gfcwfzkm/t9k-baseboard/examples/README.md

# Example Projects

This directory contains example projects that demonstrate how to use the Tang Nano 9k board with this base board. Here a list of the example projects:

- [Simple Counter](01_starting_project): A simple counter that uses the six LEDs on the Tang Nano 9k board, serves as "Getting Started" project.

- [RGB LED and Rotary Encoder](02_RGBLED): A project that uses the RGB LED and the rotary encoder on the Tang Nano 9k board.

- [HDMI Demo](03_HDMI_demo): A demo that shows how to use the HDMI output on the Tang Nano 9k board. It generates a simple test color pattern and displays the Swiss flag on a 1920x1080@30p HDMI display.

- [Simple CPU](TC-Overture-CPU): A simple CPU that can execute a few instructions. It is a good starting point for learning how to build a CPU on the Tang Nano 9k board.
