gfcwfzkm/t9k-baseboard/examples/01_starting_project/README.md

# Simple Counter / Getting Started Project

This is a simple counter that uses the six LEDs on the Tang Nano 9k board. It serves as a "Getting Started" project. The LEDs count up every 6'750'000 clock cycles, or every quarter second. Uses the S1 button to reset the counter.
