gfcwfzkm/t9k-baseboard/docs/Pinmap.pdf

30.06.2024 | | | | | Pascal G. (https://github.com/gfcwfzkm/)
Feature | I/O NAME | PIN | PIN | I/O NAME | Feature
3.3V | 3.3V
1.1 | IOB33A | 39 | 28 | IOB11B | 1.1
1.2 | IOB29B | 36 | 27 | IOB11A | 1.2
1.3 | IOB31A | 37 | 26 | IOB8B | 1.3
1.4 | IOB31B | 38 | 25 | IOB8A | 1.4
1.5 | IOR24A | 49 | 34 | IOB23B | 1.5
1.6 | IOR24B | 48 | 33 | IOB23A | 1.6
1.7 | IOT37B | 76 | 30 | IOB13B | 1.7
1.8 | IOT37A | 77 | 29 | IOB13A | 1.8
3.3V | 3.3V
1.1 | IOB41B | 42 | 32 | IOB15B | 1.1
1.2 | IOB41A | 41 | 31 | IOB15A | 1.2
1.3 | IOB29A | 35 | 57 | IOR13A | 1.3
1.4 | IOB33B | 40 | 56 | IOR14A | 1.4
1.5 | IOR14B | 55
1.6 | IOR15A | 54
1.7 | IOR15B | 53 | 63 | IOR5A | RGBLED
1.8 | IOR17B | 51
1.8V
1.8V | 83 | IOT10B | Center
A | IOT10A | 84 | 82 | IOT11A | Left
B | IOT8B | 85 | 81 | IOT11B | Up
Center | IOT8A | 86 | 80 | IOT12A | Right
| | | 79 | IOT12B | Down
1.8V
LED1 | IOL15A | 10 | 3.3V
LED2 | IOL16B | 11 | 49 | IOR24A | R/S
LED3 | IOL21B | 13 | 77 | IOT37A | MOSI
LED4 | IOL22B | 14 | 76 | IOT37B | SCLK
LED5 | IOL25B | 15 | 48 | IOR24B | !CS
LED6 | IOL26B | 16 | 47 | IOB43B | !Reset
1.8V | 3.3V
S1 | IOL5A | 4 | 38 | IOB31B | !CS
S2 | IOT2A | 3 | 37 | IOB31A | MOSI
| | | 36 | IOB29B | SCLK
3.3V | 39 | IOB33A | MISO
MOSI | IOR11B | 61
MISO | IOR11A | 62 | 3.3V
SCLK | IOR12B | 59 | 52 | IOR17A | 27 MHz
!CS | IOR12A | 60
3.3V
| | | 17 | IOB2A | FPGA-TX
| | | 18 | IOB2B | FPGA-RX

INFO

Note: All Buttons, Joysticks, Encoders or non-RGB LEDs are "Active-Low"!

# Tang Nano 9k FPGA Base board Shared with PMOD ¹ Shared with PMOD ¹

PMOD 1 | PMOD 2
PMOD 3 | PMOD 4

ENCODER

Shared with
TF CARD

Shared with
SPI LCD

PC UART

SPI FLASH

SerialRGB

JOYSTICK

SPI LCD

LEDs

BUTTONS | TF CARD

XTAL Clock
