gfcwfzkm/t9k-baseboard/images/3drender_1.png

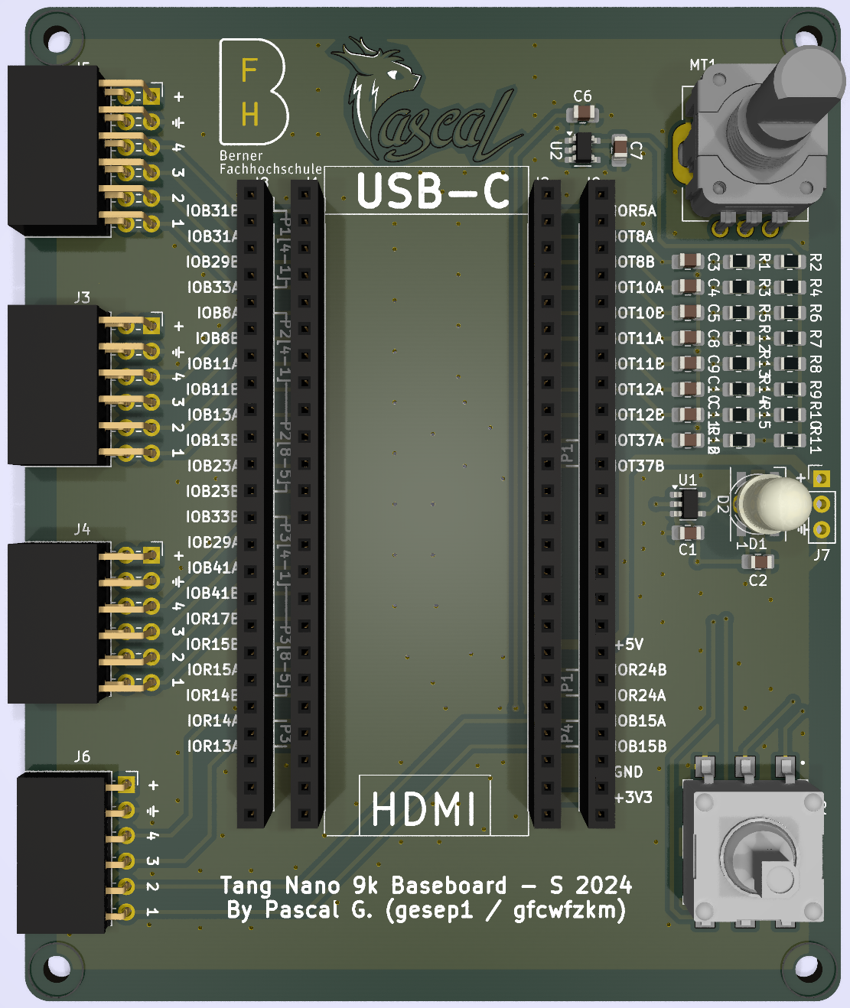
images/3drender_1.png
