gfcwfzkm/t9k-baseboard/images/3drender_2.png

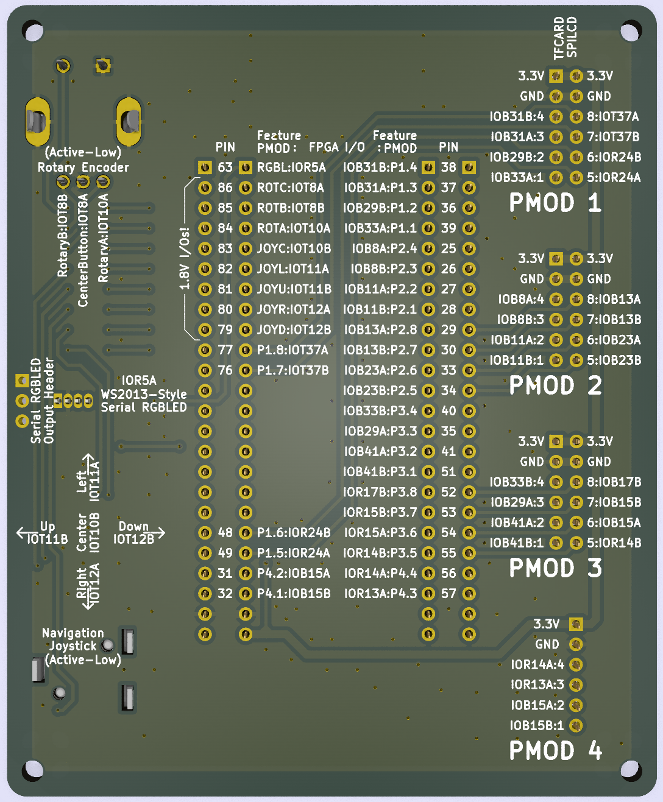
images/3drender_2.png
