gfcwfzkm/t9k-baseboard/docs/BOM.xlsx

Note: This BOM sheet summarizes the costs for a small production run of 10 pieces, which was the target of this project.
Reference | Value | Footprint | Qty | DNP | DigiKey_Part_Number | Price 10 PCS
C1,C2 | 100nF | Capacitor_SMD:C_0805_2012Metric_Pad1.18x1.45mm_HandSolder | 2 |  | 311-1140-1-ND | CHF 1.28 |  | +1 for everyone
C3,C4,C5,C8,C9,C10,C11,C12 | 10nF | Capacitor_SMD:C_0805_2012Metric_Pad1.18x1.45mm_HandSolder | 8 |  | 311-1136-1-ND | CHF 2.43 |  | +1 for everyone
C6,C7 | 2.2uF | Capacitor_SMD:C_0805_2012Metric_Pad1.18x1.45mm_HandSolder | 2 |  | 4713-GMC21X7R225K25NTCT-ND | CHF 1.16 |  | +1 for everyone
D1 | APA-106-F5 | LED_THT:LED_D5.0mm-4_RGB | 1 |  | 1568-1202-ND | CHF 12.76
J1,J2,J8,J9 | FPGA I/O | Connector_PinSocket_2.54mm:PinSocket_1x24_P2.54mm_Vertical | 4 |  | S7057-ND | CHF 45.68
J3,J4,J5 | PMOD-FULL | Connector_PinSocket_2.54mm:PinSocket_2x06_P2.54mm_Horizontal | 3 |  | 732-613012243121-ND | CHF 23.86
J6 | PMOD-HALF | Connector_PinSocket_2.54mm:PinSocket_1x06_P2.54mm_Horizontal | 1 |  | 732-613006143121-ND | CHF 4.90
MT1 | PEC11R-4115F-S0018 | PEC11R-4215F-S0024:XDCR_PEC11R-4215F-S0024 | 1 |  | PEC11R-4115F-S0018-ND | CHF 11.46
R1,R2,R3,R4,R5,R6,R7,R8,R9,R10,R11,R12,R13,R14,R15,R16 | 10k | Resistor_SMD:R_0805_2012Metric_Pad1.20x1.40mm_HandSolder | 16 |  | 311-10.0KCRCT-ND | CHF 2.06 |  | +2 for everyone
S1 | JS5208 | JS5208:SW_JS5208 | 1 |  | EG4561-ND | CHF 24.51
U1 | SN74LV1T34DBV | Package_TO_SOT_SMD:SOT-23-5 | 1 |  | 296-37176-1-ND | CHF 2.81 |  | 2 reserve, in case someone ruins / looses one
U2 | AP2205-18W5-7 | Package_TO_SOT_SMD:SOT-23-5 | 1 |  | 31-AP2205-18W5-7CT-ND | CHF 3.37
 |  |  |  | TOTAL COMPONENTS EXCL. FPGA: |  | CHF 136.28
PCB costs at JLCPCB (blue, HASL (lead), 2 Layers, 99 x 81 mm, 10 Stück |  |  |  |  |  | CHF 5.00 |  | ~20 CHF shipping
FPGA Sipeed Tang 9k |  | Base variant |  |  |  | CHF 14.68 | Students would order the FPGA separately as some students want other LCDs to go with it.
 |  | With 7" LCD |  |  |  | CHF 35.88
 |  | With 5" LCD |  |  |  | CHF 32.09
 |  | With 4.3" LCD |  |  |  | CHF 26.34
 |  | With 1.14" LCD |  |  |  | CHF 17.78
 | Project cost per student (Excl. Shipping, with FPGA base variant) |  |  |  |  | CHF 33.31
 |  |  | An FPGA Development System for around ~30 CHF!
