gfcwfzkm/t9k-baseboard/docs/SCHEMA.pdf

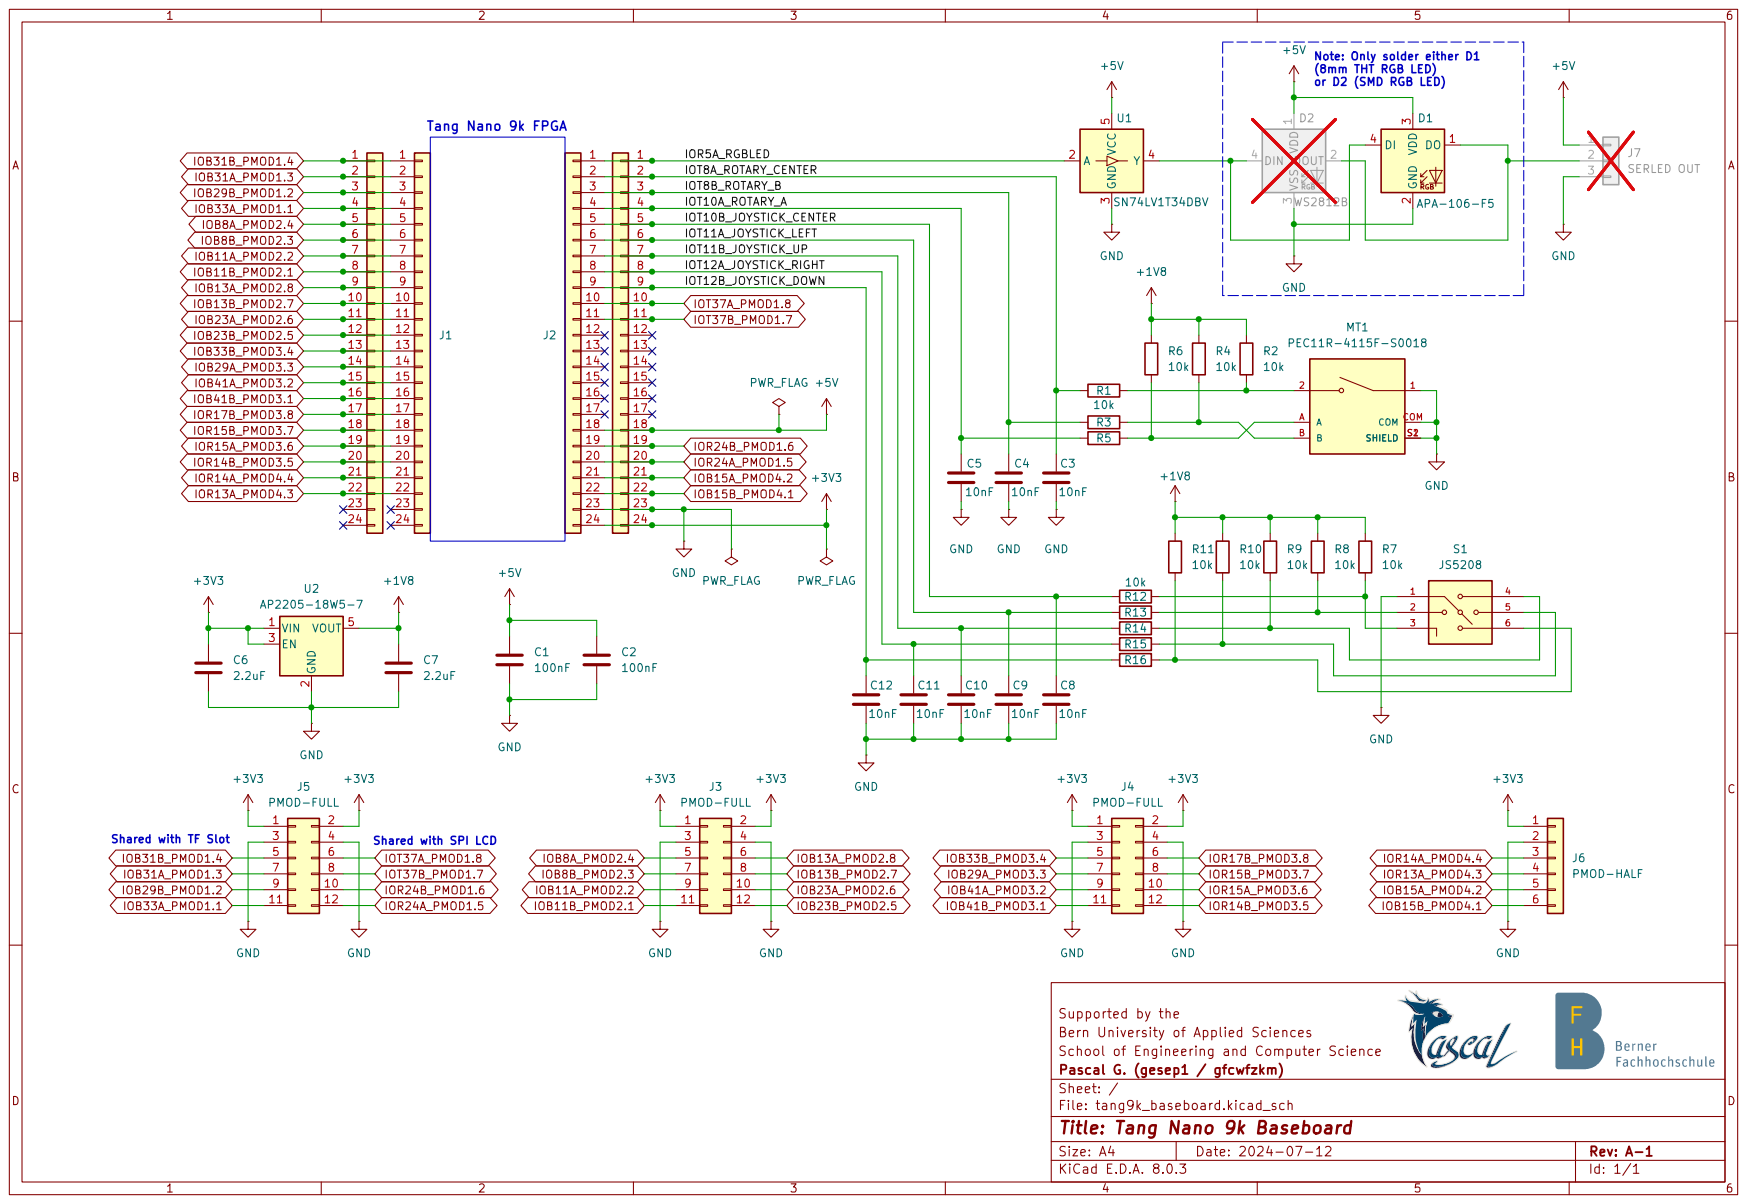
[picture p14: page 1]
