gfcwfzkm/t9k-baseboard/kicad/tang9k_baseboard.kicad_pcb

## KiCad design kicad/tang9k_baseboard.kicad_pcb (2024-07-13)

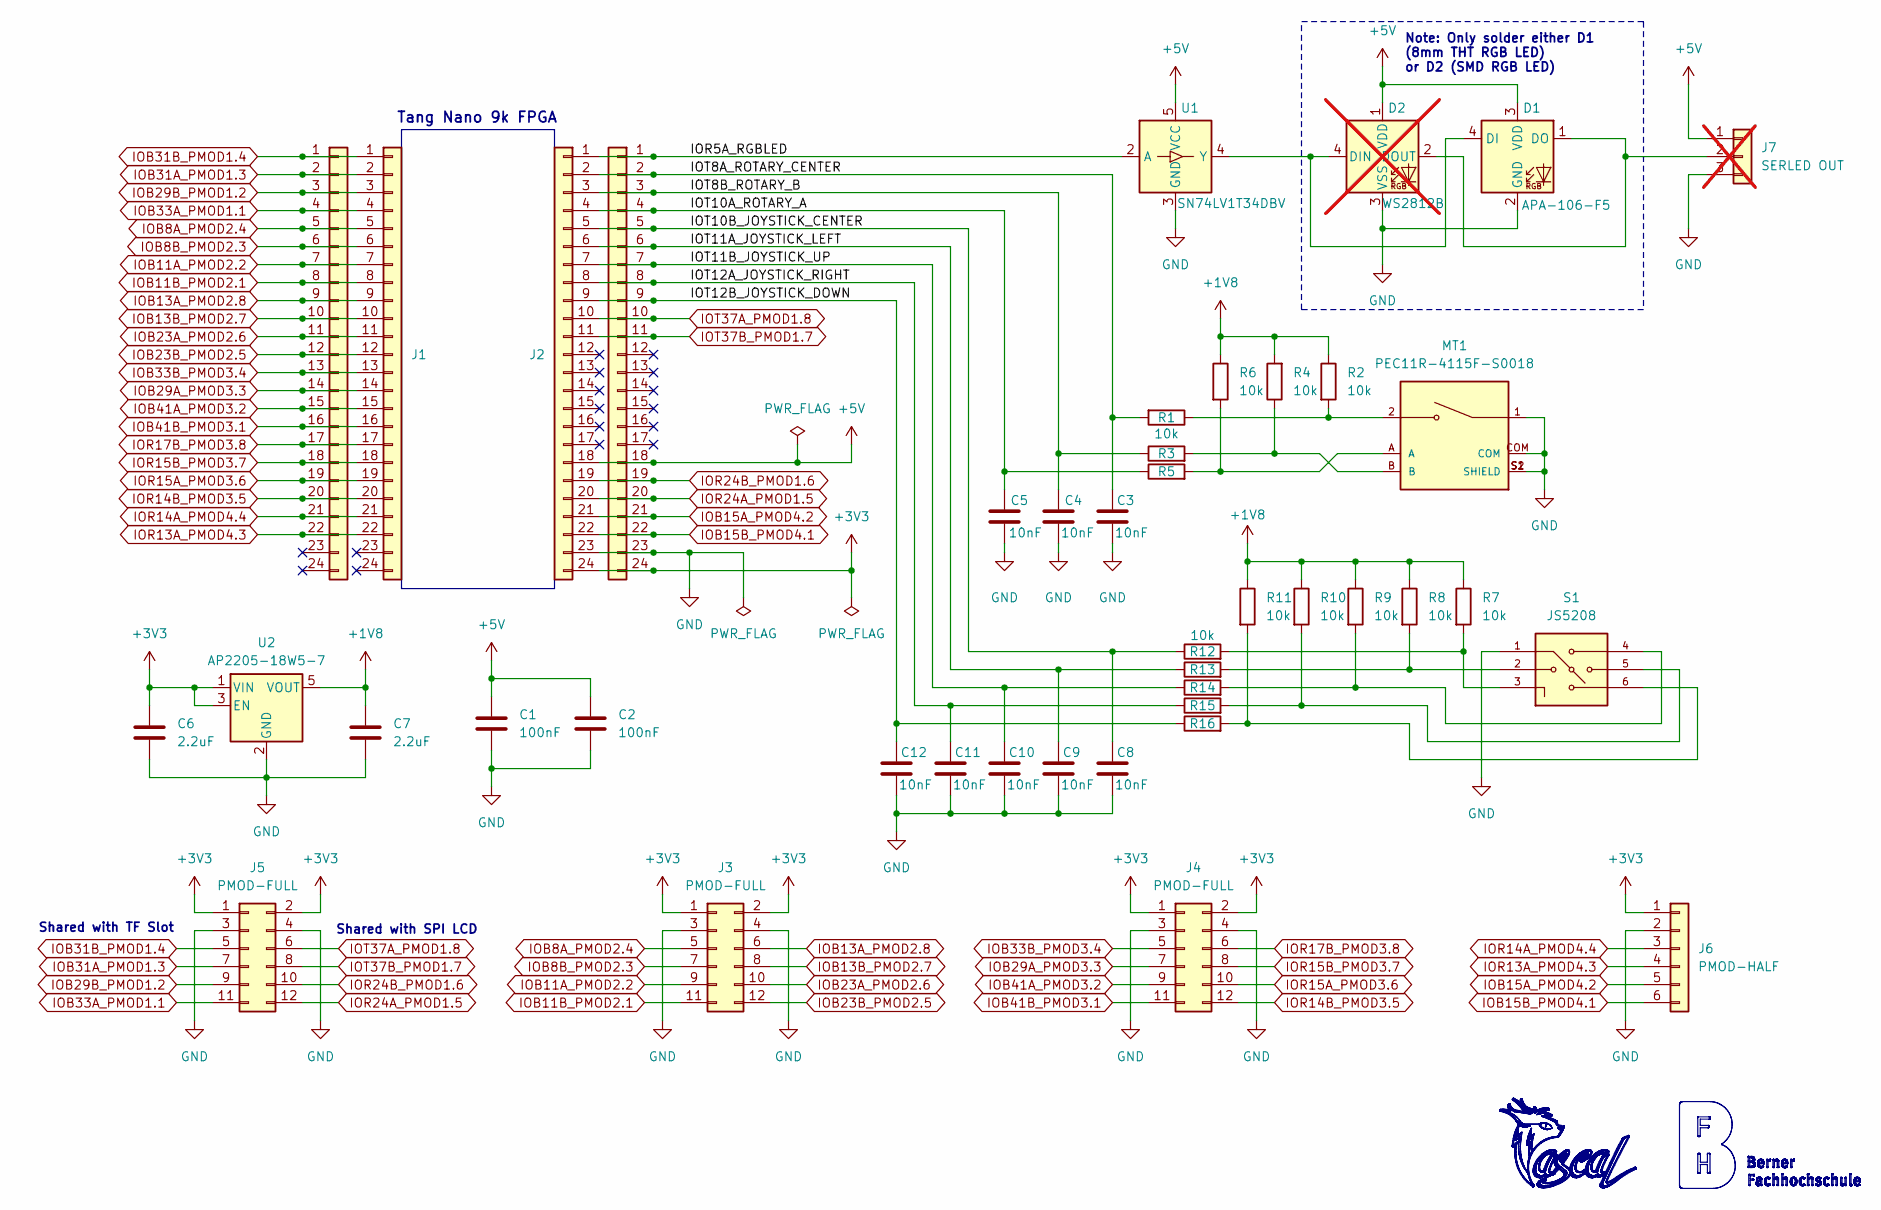
[picture p15: schematic tang9k_baseboard.kicad_sch, Tang Nano 9k Baseboard]

Parts:
C1, C2: 100nF; C_0805_2012Metric_Pad1.18x1.45mm_HandSolder; DigiKey_Part_Number 311-1140-1-ND
C3, C4, C5, C8, C9, C10, C11, C12: 10nF; C_0805_2012Metric_Pad1.18x1.45mm_HandSolder; DigiKey_Part_Number 311-1136-1-ND
C6, C7: 2.2uF; C_0805_2012Metric_Pad1.18x1.45mm_HandSolder; DigiKey_Part_Number 4713-GMC21X7R225K25NTCT-ND
D1: APA-106-F5; LED_D5.0mm-4_RGB; DigiKey_Part_Number 1568-1202-ND
D2: WS2812B; LED_WS2812B_PLCC4_5.0x5.0mm_P3.2mm; DigiKey_Part_Number 1568-COM-16347CT-ND; not fitted
J1, J2, J8, J9: FPGA I/O; PinSocket_1x24_P2.54mm_Vertical; DigiKey_Part_Number S7057-ND
J3, J4, J5: PMOD-FULL; PinSocket_2x06_P2.54mm_Horizontal; DigiKey_Part_Number 732-613012243121-ND
J6: PMOD-HALF; PinSocket_1x06_P2.54mm_Horizontal; DigiKey_Part_Number 732-613006143121-ND
J7: SERLED OUT; PinHeader_1x03_P2.54mm_Vertical; not fitted
MT1: PEC11R-4115F-S0018; XDCR_PEC11R-4215F-S0024; PARTREV Rev. 09/19; DigiKey_Part_Number PEC11R-4115F-S0018-ND
R1, R2, R3, R4, R5, R6, R7, R8, R9, R10, R11, R12, R13, R14, R15, R16: 10k; R_0805_2012Metric_Pad1.20x1.40mm_HandSolder; DigiKey_Part_Number 311-10.0KCRCT-ND
S1: JS5208; SW_JS5208; PARTREV D; DigiKey_Part_Number EG4561-ND
U1: SN74LV1T34DBV; SOT-23-5; DigiKey_Part_Number 296-37176-1-ND
U2: AP2205-18W5-7; SOT-23-5; DigiKey_Part_Number 31-AP2205-18W5-7CT-ND

Connections:
+1V8: C7.1, R2.1, R4.2, R6.1, R7.1, R8.1, R9.1, R10.1, R11.1, U2.5 (VOUT)
+3V3: C6.1, J2.24, J3.1, J3.2, J4.1, J4.2, J5.1, J5.2, J6.1, J9.24, U2.1 (VIN), U2.3 (EN)
+5V: C1.1, C2.1, D1.3 (VDD), D2.1 (VDD), J2.18, J7.1, J9.18, U1.5 (VCC)
/IOR5A_RGBLED: J2.1, J9.1, U1.2 (A)
/IOT8A_ROTARY_CENTER: C3.1, J2.2, J9.2, R1.2
/IOT8B_ROTARY_B: C4.1, J2.3, J9.3, R3.1
/IOT10A_ROTARY_A: C5.1, J2.4, J9.4, R5.1
/IOT10B_JOYSTICK_CENTER: C8.1, J2.5, J9.5, R12.1
/IOT11A_JOYSTICK_LEFT: C9.1, J2.6, J9.6, R13.1
/IOT11B_JOYSTICK_UP: C10.1, J2.7, J9.7, R14.1
/IOT12A_JOYSTICK_RIGHT: C11.1, J2.8, J9.8, R15.1
/IOT12B_JOYSTICK_DOWN: C12.1, J2.9, J9.9, R16.1
IOB8A_PMOD2.4: J1.5, J3.5, J8.5
IOB8B_PMOD2.3: J1.6, J3.7, J8.6
IOB11A_PMOD2.2: J1.7, J3.9, J8.7
IOB11B_PMOD2.1: J1.8, J3.11, J8.8
IOB13A_PMOD2.8: J1.9, J3.6, J8.9
IOB13B_PMOD2.7: J1.10, J3.8, J8.10
IOB15A_PMOD4.2: J2.21, J6.5, J9.21
IOB15B_PMOD4.1: J2.22, J6.6, J9.22
IOB23A_PMOD2.6: J1.11, J3.10, J8.11
IOB23B_PMOD2.5: J1.12, J3.12, J8.12
IOB29A_PMOD3.3: J1.14, J4.7, J8.14
IOB29B_PMOD1.2: J1.3, J5.9, J8.3
IOB31A_PMOD1.3: J1.2, J5.7, J8.2
IOB31B_PMOD1.4: J1.1, J5.5, J8.1
IOB33A_PMOD1.1: J1.4, J5.11, J8.4
IOB33B_PMOD3.4: J1.13, J4.5, J8.13
IOB41A_PMOD3.2: J1.15, J4.9, J8.15
IOB41B_PMOD3.1: J1.16, J4.11, J8.16
IOR13A_PMOD4.3: J1.22, J6.4, J8.22
IOR14A_PMOD4.4: J1.21, J6.3, J8.21
IOR14B_PMOD3.5: J1.20, J4.12, J8.20
IOR15A_PMOD3.6: J1.19, J4.10, J8.19
IOR15B_PMOD3.7: J1.18, J4.8, J8.18
IOR17B_PMOD3.8: J1.17, J4.6, J8.17
IOR24A_PMOD1.5: J2.20, J5.12, J9.20
IOR24B_PMOD1.6: J2.19, J5.10, J9.19
IOT37A_PMOD1.8: J2.10, J5.6, J9.10
IOT37B_PMOD1.7: J2.11, J5.8, J9.11
unnamed: D1.4 (DI), D2.4 (DIN), U1.4 (Y)
unnamed: D1.1 (DO), D2.2 (DOUT), J7.2
unnamed: MT1.2, R1.1, R2.2
unnamed: MT1.A, R5.2, R6.2
unnamed: MT1.B, R3.2, R4.1
unnamed: R10.2, R15.2, S1.5
unnamed: R11.2, R16.2, S1.6
unnamed: R8.2, R13.2, S1.2
unnamed: R9.2, R14.2, S1.4

Notes on the sheet:
Tang Nano 9k FPGA
Note: Only solder either D1 (8mm THT RGB LED) or D2 (SMD RGB LED)
Shared with SPI LCD
Shared with TF Slot

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
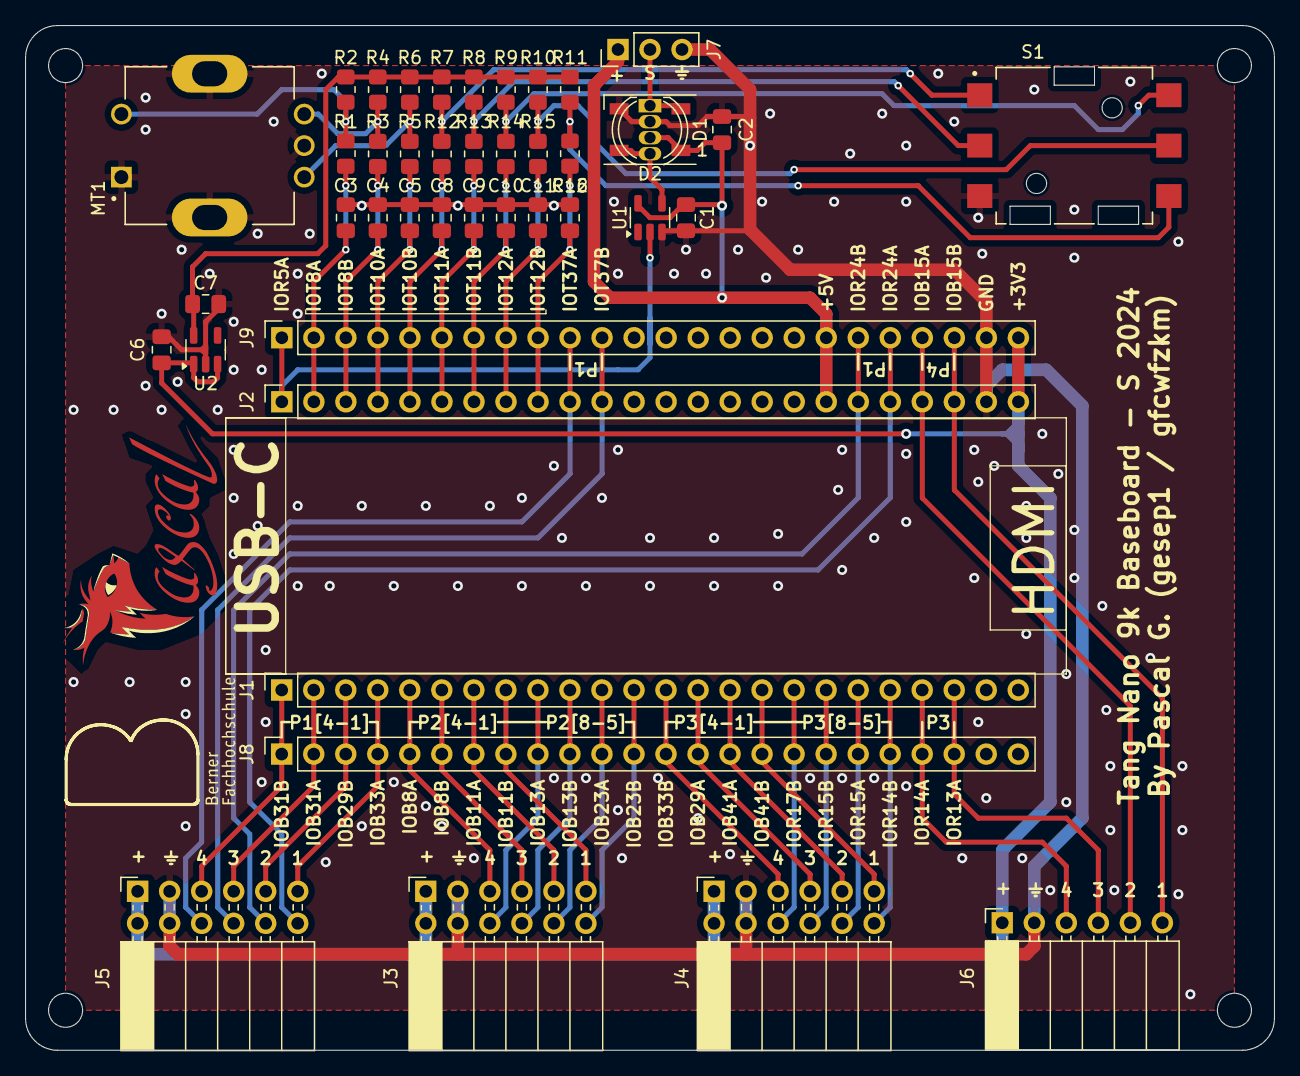
[picture p16: board tang9k_baseboard.kicad_pcb from above]

Board: 2 copper layers, 99.1 x 81.3 mm, 43 parts (0 on the bottom side), 51 nets.
