gfcwfzkm/t9k-baseboard/examples/03_HDMI_demo/src/gowin_clkdiv/gowin_clkdiv.vhd

--Copyright (C)2014-2024 Gowin Semiconductor Corporation.
--All rights reserved.
--File Title: IP file
--Tool Version: V1.9.10.02
--Part Number: GW1NR-LV9QN88PC6/I5
--Device: GW1NR-9
--Device Version: C
--Created Time: Sun Jun  8 12:50:28 2025

library IEEE;
use IEEE.std_logic_1164.all;

entity Gowin_CLKDIV is
    port (
        clkout: out std_logic;
        hclkin: in std_logic;
        resetn: in std_logic
    );
end Gowin_CLKDIV;

architecture Behavioral of Gowin_CLKDIV is

    signal gw_gnd: std_logic;

    --component declaration
    component CLKDIV
        generic (
            GSREN: STRING := "false";
            DIV_MODE : STRING := "2"
        );
        port (
            CLKOUT: out std_logic;
            HCLKIN: in std_logic;
            RESETN: in std_logic;
            CALIB: in std_logic
        );
    end component;

begin
    gw_gnd <= '0';

    clkdiv_inst: CLKDIV
        generic map (
            GSREN => "false",
            DIV_MODE => "5"
        )
        port map (
            CLKOUT => clkout,
            HCLKIN => hclkin,
            RESETN => resetn,
            CALIB => gw_gnd
        );

end Behavioral; --Gowin_CLKDIV
