gfcwfzkm/t9k-baseboard/(commit log)

2024-07-01 Initial commit of this project
    [BOM.xlsx, Pinmap.xlsx, tang9k_baseboard.kicad_pcb, tang9k_baseboard.kicad_sch]
2024-07-12 Fixed minor silkscreen issues
    [tang9k_baseboard.kicad_pcb, tang9k_baseboard.kicad_sch]
2024-07-13 Added step-by-step guide, fixed Pinmap error
    [Pinmap.xlsx]
2024-07-13 Updated silkscreen & 3D renders
    [tang9k_baseboard.kicad_pcb]
2024-09-30 Initial push of the RGB LED Driver/Demo
2024-10-18 Added RGB-LED example
2025-07-02 Due to githubs issue to render tabs at a sane size, changed it to spaces.
    [cycle_colors.vhdl, hdmi_demo_top.vhdl, helper_pkg.vhdl, hsv_to_rgb.vhdl, rgb_to_ser.vhdl, rgb_to_ser_tb.vhdl, rotary_enc.vhdl, tb_tmds_encoder.vhdl]
2025-07-02 Added docs explaining the RGB-LED example
